noradtux/evnotipi-hat/evnotipi-hat.kicad_pcb

## KiCad design evnotipi-hat.kicad_pcb (2020-08-14)

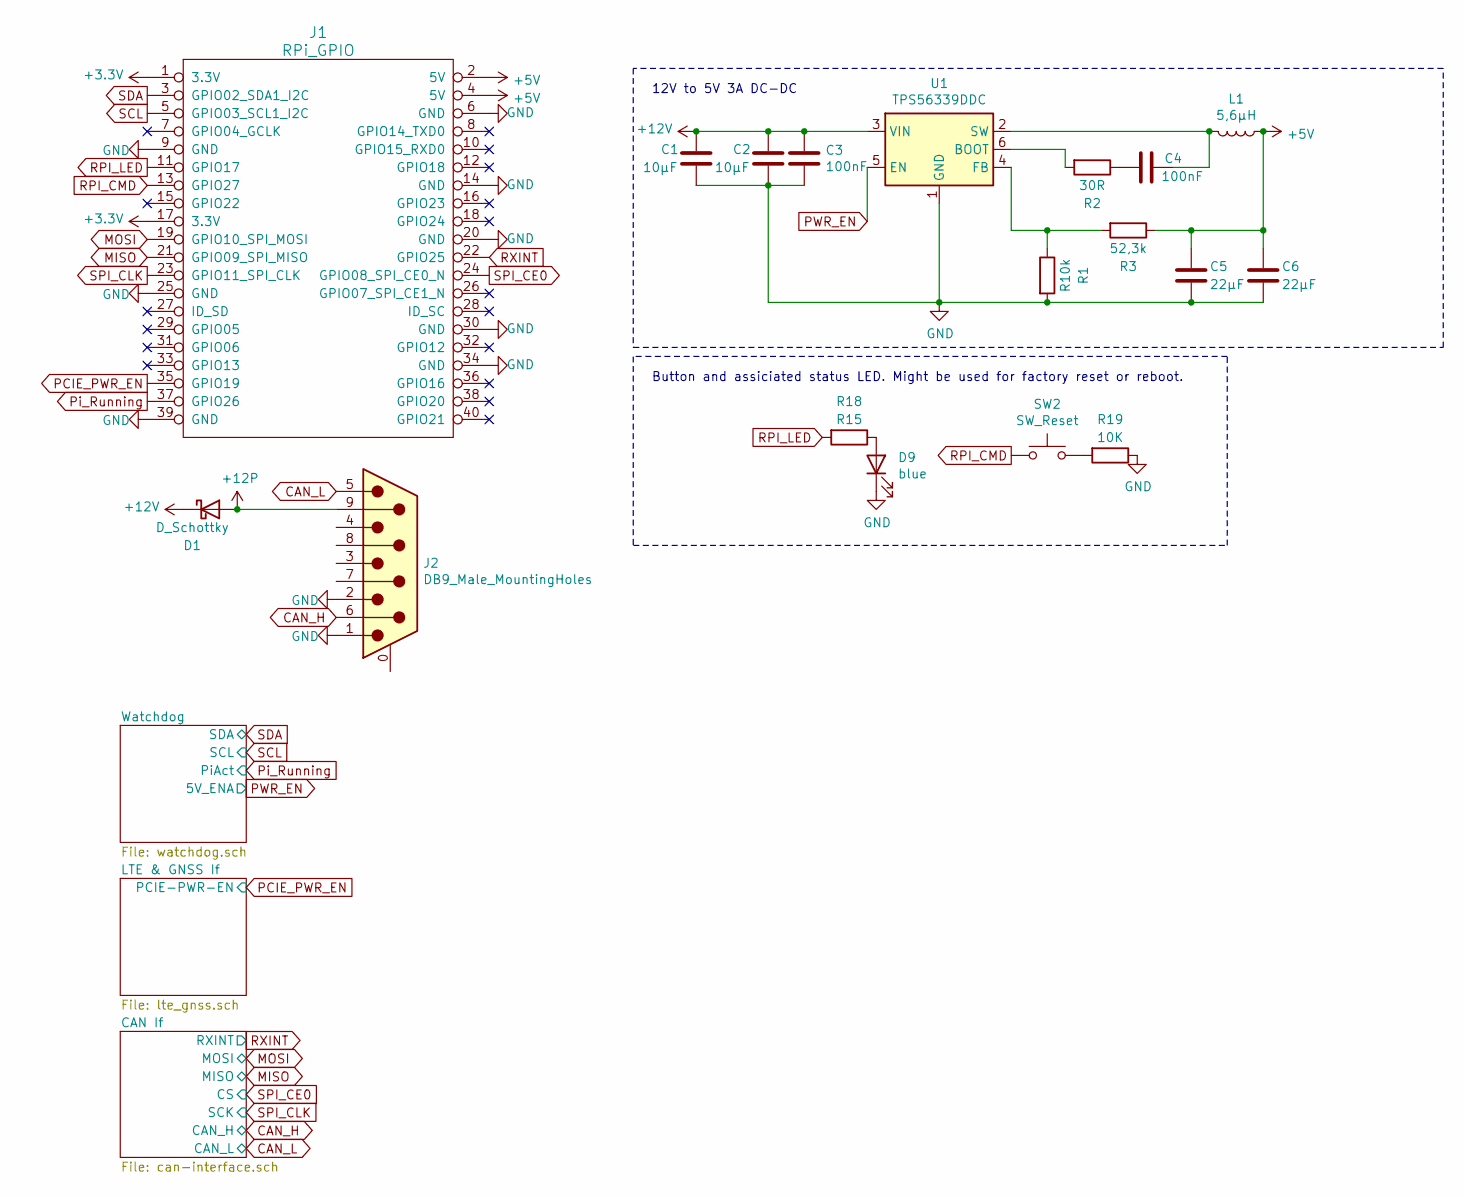
[picture p1: schematic evnotipi-hat.sch]

Parts:
C1, C2: 10µF; C_0805_2012Metric_Pad1.15x1.40mm_HandSolder
C3, C4: 100nF; C_0805_2012Metric_Pad1.15x1.40mm_HandSolder
C5, C6: 22µF; C_0805_2012Metric_Pad1.15x1.40mm_HandSolder
D1: D_Schottky; D_SOD-128
D9: blue; LED_0603_1608Metric
J1: RPi_GPIO; Samtec_HLE-120-02-xxx-DV-BE-A_2x20_RPi_Top
J2: DB9_Male_MountingHoles; DSUB-9_Male_Horizontal_P2.77x2.84mm_EdgePinOffset4.94mm_Hou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
L1: 5,6µH; L_Coilcraft_XAL60xx_6.36x6.56mm
R1: R10k; R_0603_1608Metric_Pad1.05x0.95mm_HandSolder
R2: 30R; R_0603_1608Metric_Pad1.05x0.95mm_HandSolder
R3: 52,3k; R_0603_1608Metric_Pad1.05x0.95mm_HandSolder
R18: R15; R_0603_1608Metric_Pad1.05x0.95mm_HandSolder
R19: 10K; R_0603_1608Metric_Pad1.05x0.95mm_HandSolder
SW2: SW_Reset; SW_SPST_B3U-1000P
U1: TPS56339DDC; SOT-23-6

Connections:
+5V: C5.1, C6.1, J1.2 (5V), J1.4 (5V), L1.1, R3.1; also elsewhere on the board
+12P: D1.2 (A), J2.9; also elsewhere on the board
+12V: C1.1, C2.1, C3.1, D1.1 (K), U1.3 (VIN); also elsewhere on the board
CAN_H: J2.6; also elsewhere on the board
CAN_L: J2.5; also elsewhere on the board
GND: C1.2, C2.2, C3.2, C5.2, C6.2, D9.1 (K), J1.6 (GND), J1.9 (GND), J1.14 (GND), J1.20 (GND), J1.25 (GND), J1.30 (GND), J1.34 (GND), J1.39 (GND), J2.1, J2.2, R1.2, R19.1, U1.1 (GND); also elsewhere on the board
MISO: J1.21 (GPIO09_SPI_MISO); also elsewhere on the board
MOSI: J1.19 (GPIO10_SPI_MOSI); also elsewhere on the board
unnamed: C4.1, L1.2, U1.2 (SW)
unnamed: C4.2, R2.1
unnamed: D9.2 (A), R18.1
unnamed: R1.1, R3.2, U1.4 (FB)
unnamed: R2.2, U1.6 (BOOT)
unnamed: R19.2, SW2.2
PCIE_PWR_EN: J1.35 (GPIO19); also elsewhere on the board
PWR_EN: U1.5 (EN); also elsewhere on the board
Pi_Running: J1.37 (GPIO26); also elsewhere on the board
RPI_CMD: J1.13 (GPIO27), SW2.1
RPI_LED: J1.11 (GPIO17), R18.2
RXINT: J1.22 (GPIO25); also elsewhere on the board
SCL: J1.5 (GPIO03_SCL1_I2C); also elsewhere on the board
SDA: J1.3 (GPIO02_SDA1_I2C); also elsewhere on the board
SPI_CE0: J1.24 (GPIO08_SPI_CE0_N); also elsewhere on the board
SPI_CLK: J1.23 (GPIO11_SPI_CLK); also elsewhere on the board

Notes on the sheet:
12V to 5V 3A DC-DC
Button and assiciated status LED. Might be used for factory reset or reboot.

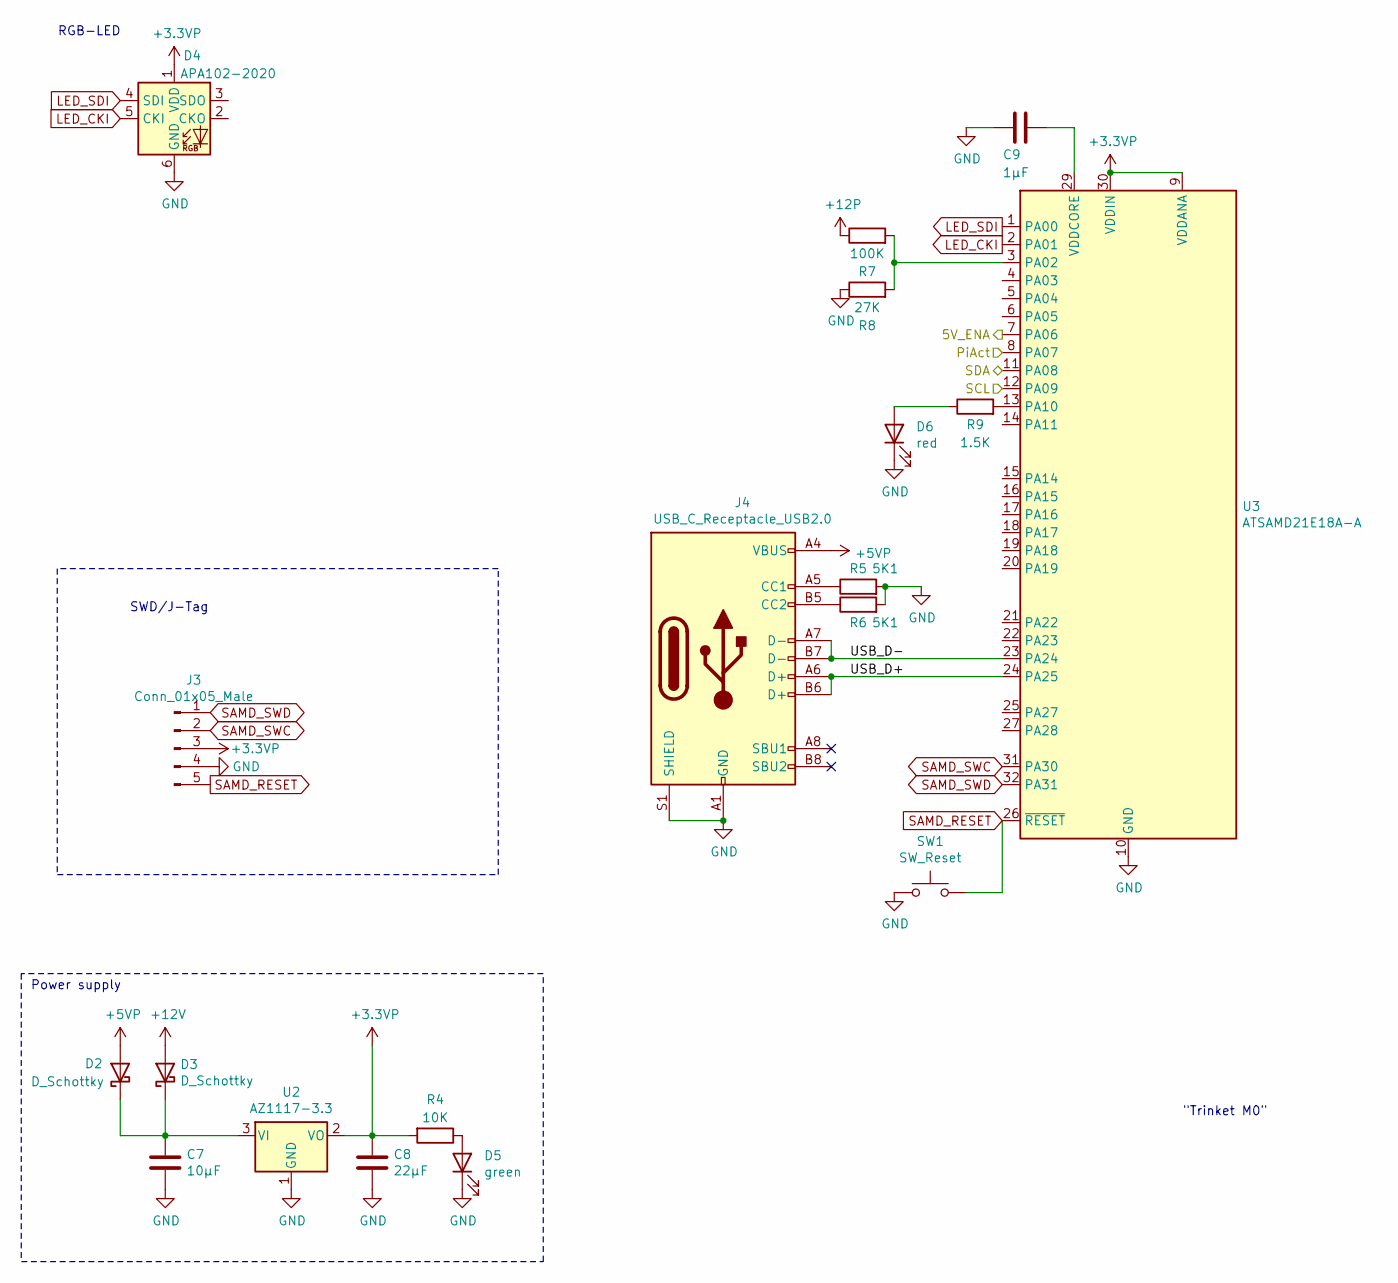
[picture p2: schematic watchdog.sch]

Parts:
C7: 10µF; C_0805_2012Metric_Pad1.15x1.40mm_HandSolder
C8: 22µF; C_0805_2012Metric_Pad1.15x1.40mm_HandSolder
C9: 1µF; C_0805_2012Metric_Pad1.15x1.40mm_HandSolder
D2, D3: D_Schottky; D_SOD-128
D4: APA102-2020; LED-APA102-2020
D5: green; LED_0603_1608Metric
D6: red; LED_0603_1608Metric
J3: Conn_01x05_Male; Molex_PicoBlade_53047-0510_1x05_P1.25mm_Vertical
J4: USB_C_Receptacle_USB2.0; USB_C_Receptacle_HRO_TYPE-C-31-M-12
R4: 10K; R_0603_1608Metric_Pad1.05x0.95mm_HandSolder
R5, R6: 5K1; R_0603_1608Metric_Pad1.05x0.95mm_HandSolder
R7: 100K; R_0603_1608Metric_Pad1.05x0.95mm_HandSolder
R8: 27K; R_0603_1608Metric_Pad1.05x0.95mm_HandSolder
R9: 1.5K; R_0603_1608Metric_Pad1.05x0.95mm_HandSolder
SW1: SW_Reset; SW_SPST_B3U-1000P
U2: AZ1117-3.3; SOT-223
U3: ATSAMD21E18A-A; TQFP-32_7x7mm_P0.8mm

Connections:
+3.3VP: C8.1, D4.1 (VDD), J3.3, R4.2, U2.2 (VO), U3.9 (VDDANA), U3.30 (VDDIN)
+5VP: D2.2 (A), J4.A4 (VBUS), J4.A9 (VBUS), J4.B4 (VBUS), J4.B9 (VBUS)
+12P: R7.1; also elsewhere on the board
+12V: D3.2 (A); also elsewhere on the board
/Watchdog/USB_D+: J4.A6 (D+), J4.B6 (D+), U3.24 (PA25)
/Watchdog/USB_D-: J4.A7 (D-), J4.B7 (D-), U3.23 (PA24)
GND: C7.2, C8.2, C9.1, D4.6 (GND), D5.1 (K), D6.1 (K), J3.4, J4.A1 (GND), J4.A12 (GND), J4.B1 (GND), J4.B12 (GND), J4.S1 (SHIELD), R5.2, R6.2, R8.1, SW1.1, U2.1 (GND), U3.10 (GND), U3.28 (GND); also elsewhere on the board
LED_CKI: D4.5 (CKI), U3.2 (PA01)
LED_SDI: D4.4 (SDI), U3.1 (PA00)
unnamed: C7.1, D2.1 (K), D3.1 (K), U2.3 (VI)
unnamed: C9.2, U3.29 (VDDCORE)
unnamed: D5.2 (A), R4.1
unnamed: D6.2 (A), R9.1
unnamed: J4.A5 (CC1), R5.1
unnamed: J4.B5 (CC2), R6.1
unnamed: R7.2, R8.2, U3.3 (PA02)
unnamed: R9.2, U3.13 (PA10)
PWR_EN: U3.7 (PA06); also elsewhere on the board
Pi_Running: U3.8 (PA07); also elsewhere on the board
SAMD_RESET: J3.5, SW1.2, U3.26 (~RESET)
SAMD_SWC: J3.2, U3.31 (PA30)
SAMD_SWD: J3.1, U3.32 (PA31)
SCL: U3.12 (PA09); also elsewhere on the board
SDA: U3.11 (PA08); also elsewhere on the board

Notes on the sheet:
"Trinket M0"
Power supply
SWD/J-Tag
RGB-LED

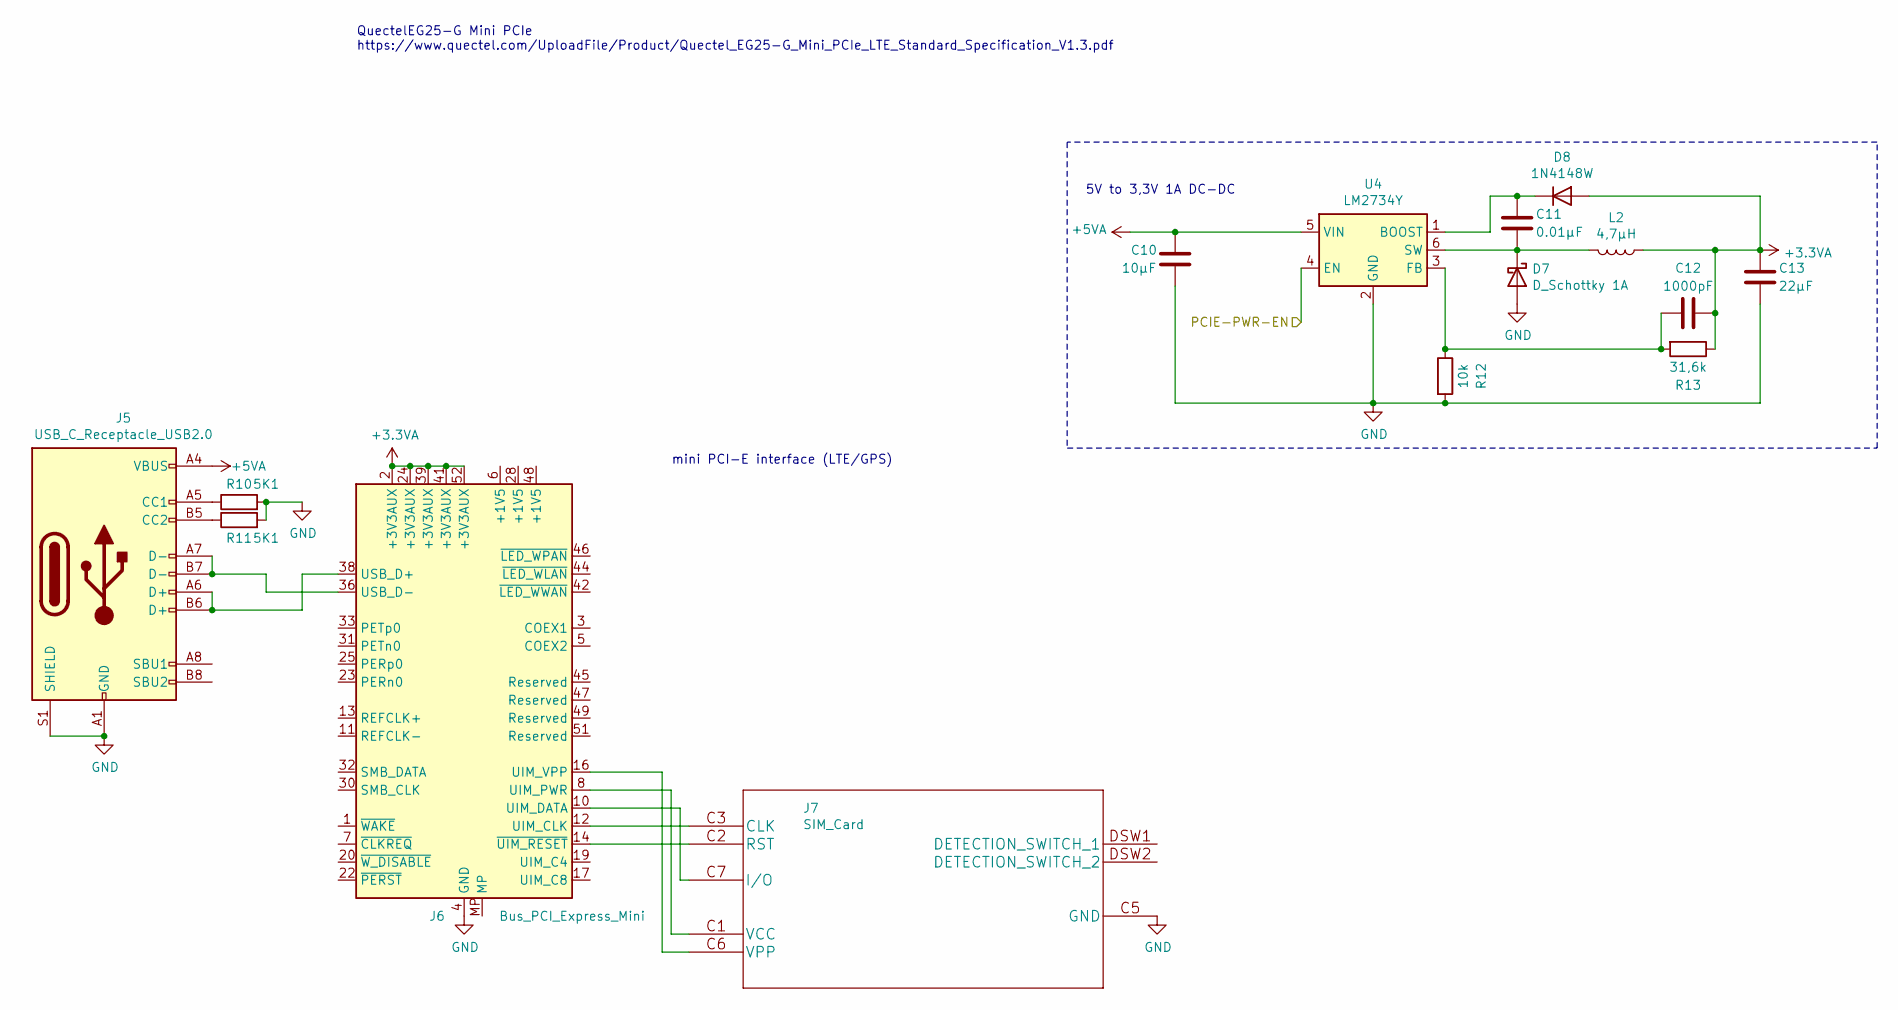
[picture p3: schematic lte_gnss.sch]

Parts:
C10: 10µF; C_0805_2012Metric_Pad1.15x1.40mm_HandSolder
C11: 0.01µF; C_0805_2012Metric_Pad1.15x1.40mm_HandSolder
C12: 1000pF; C_0805_2012Metric_Pad1.15x1.40mm_HandSolder
C13: 22µF; C_0805_2012Metric_Pad1.15x1.40mm_HandSolder
D7: D_Schottky 1A; D_SOD-128
D8: 1N4148W; D_SOD-128
J5: USB_C_Receptacle_USB2.0; USB_C_Receptacle_HRO_TYPE-C-31-M-12
J6: Bus_PCI_Express_Mini; BUS_PCI_Express_Mini_Full
J7: SIM_Card; SF56S006V4BR2000
L2: 4,7µH; L_Coilcraft_XAL60xx_6.36x6.56mm
R10, R11: 5K1; R_0603_1608Metric_Pad1.05x0.95mm_HandSolder
R12: 10k; R_0603_1608Metric_Pad1.05x0.95mm_HandSolder
R13: 31,6k; R_0603_1608Metric_Pad1.05x0.95mm_HandSolder
U4: LM2734Y; TSOT-23-6_HandSoldering

Connections:
+3.3VA: C12.1, C13.1, D8.2 (A), J6.2 (+3V3AUX), J6.24 (+3V3AUX), J6.39 (+3V3AUX), J6.41 (+3V3AUX), J6.52 (+3V3AUX), L2.1, R13.1
+5VA: C10.1, J5.A4 (VBUS), J5.A9 (VBUS), J5.B4 (VBUS), J5.B9 (VBUS), U4.5 (VIN)
GND: C10.2, C13.2, D7.2 (A), J5.A1 (GND), J5.A12 (GND), J5.B1 (GND), J5.B12 (GND), J5.S1 (SHIELD), J6.4 (GND), J6.9 (GND), J6.15 (GND), J6.18 (GND), J6.21 (GND), J6.26 (GND), J6.27 (GND), J6.29 (GND), J6.34 (GND), J6.35 (GND), J6.37 (GND), J6.40 (GND), J6.43 (GND), J6.50 (GND), J7.C5 (GND), R10.2, R11.2, R12.2, U4.2 (GND); also elsewhere on the board
unnamed: C11.1, D8.1 (K), U4.1 (BOOST)
unnamed: C11.2, D7.1 (K), L2.2, U4.6 (SW)
unnamed: C12.2, R12.1, R13.2, U4.3 (FB)
unnamed: J5.A5 (CC1), R10.1
unnamed: J5.A6 (D+), J5.B6 (D+), J6.38 (USB_D+)
unnamed: J5.A7 (D-), J5.B7 (D-), J6.36 (USB_D-)
unnamed: J5.B5 (CC2), R11.1
unnamed: J6.8 (UIM_PWR), J7.C1 (VCC)
unnamed: J6.10 (UIM_DATA), J7.C7 (I/O)
unnamed: J6.12 (UIM_CLK), J7.C3 (CLK)
unnamed: J6.14 (~UIM_RESET), J7.C2 (RST)
unnamed: J6.16 (UIM_VPP), J7.C6 (VPP)
PCIE_PWR_EN: U4.4 (EN); also elsewhere on the board

Notes on the sheet:
QuectelEG25-G Mini PCIe https://www.quectel.com/UploadFile/Product/Quectel_EG25-G_Mini_PCIe_LTE_Standard_Specification_V1.3.pdf
mini PCI-E interface (LTE/GPS)
5V to 3,3V 1A DC-DC

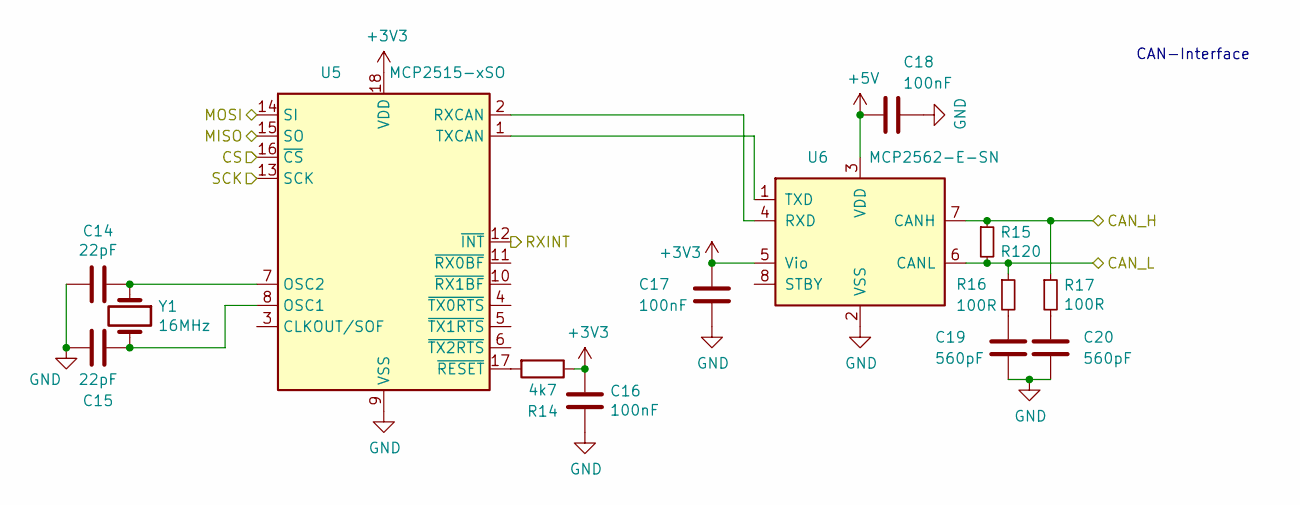
[picture p4: schematic can-interface.sch]

Parts:
C14, C15: 22pF; C_0805_2012Metric_Pad1.15x1.40mm_HandSolder
C16, C17, C18: 100nF; C_0805_2012Metric_Pad1.15x1.40mm_HandSolder
C19, C20: 560pF; C_0805_2012Metric_Pad1.15x1.40mm_HandSolder
R14: 4k7; R_0603_1608Metric_Pad1.05x0.95mm_HandSolder
R15: R120; R_0603_1608Metric_Pad1.05x0.95mm_HandSolder
R16, R17: 100R; R_0603_1608Metric_Pad1.05x0.95mm_HandSolder
U5: MCP2515-xSO; SOIC-18W_7.5x11.6mm_P1.27mm
U6: MCP2562-E-SN; SOIC-8_3.9x4.9mm_P1.27mm
Y1: 16MHz; Crystal_SMD_Abracon_ABM3-2Pin_5.0x3.2mm

Connections:
+5V: C18.1, U6.3 (VDD); also elsewhere on the board
CAN_H: R15.1, R17.1, U6.7 (CANH); also elsewhere on the board
CAN_L: R15.2, R16.1, U6.6 (CANL); also elsewhere on the board
GND: C14.2, C15.2, C16.1, C17.1, C18.2, C19.1, C20.1, U5.9 (VSS), U6.2 (VSS); also elsewhere on the board
MISO: U5.15 (SO); also elsewhere on the board
MOSI: U5.14 (SI); also elsewhere on the board
unnamed: C14.1, U5.7 (OSC2), Y1.1
unnamed: C15.1, U5.8 (OSC1), Y1.2
unnamed: C19.2, R16.2
unnamed: C20.2, R17.2
unnamed: R14.2, U5.17 (~RESET)
unnamed: U5.1 (TXCAN), U6.1 (TXD)
unnamed: U5.2 (RXCAN), U6.4 (RXD)
RXINT: U5.12 (~INT); also elsewhere on the board
SPI_CE0: U5.16 (~CS); also elsewhere on the board
SPI_CLK: U5.13 (SCK); also elsewhere on the board

Notes on the sheet:
CAN-Interface

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
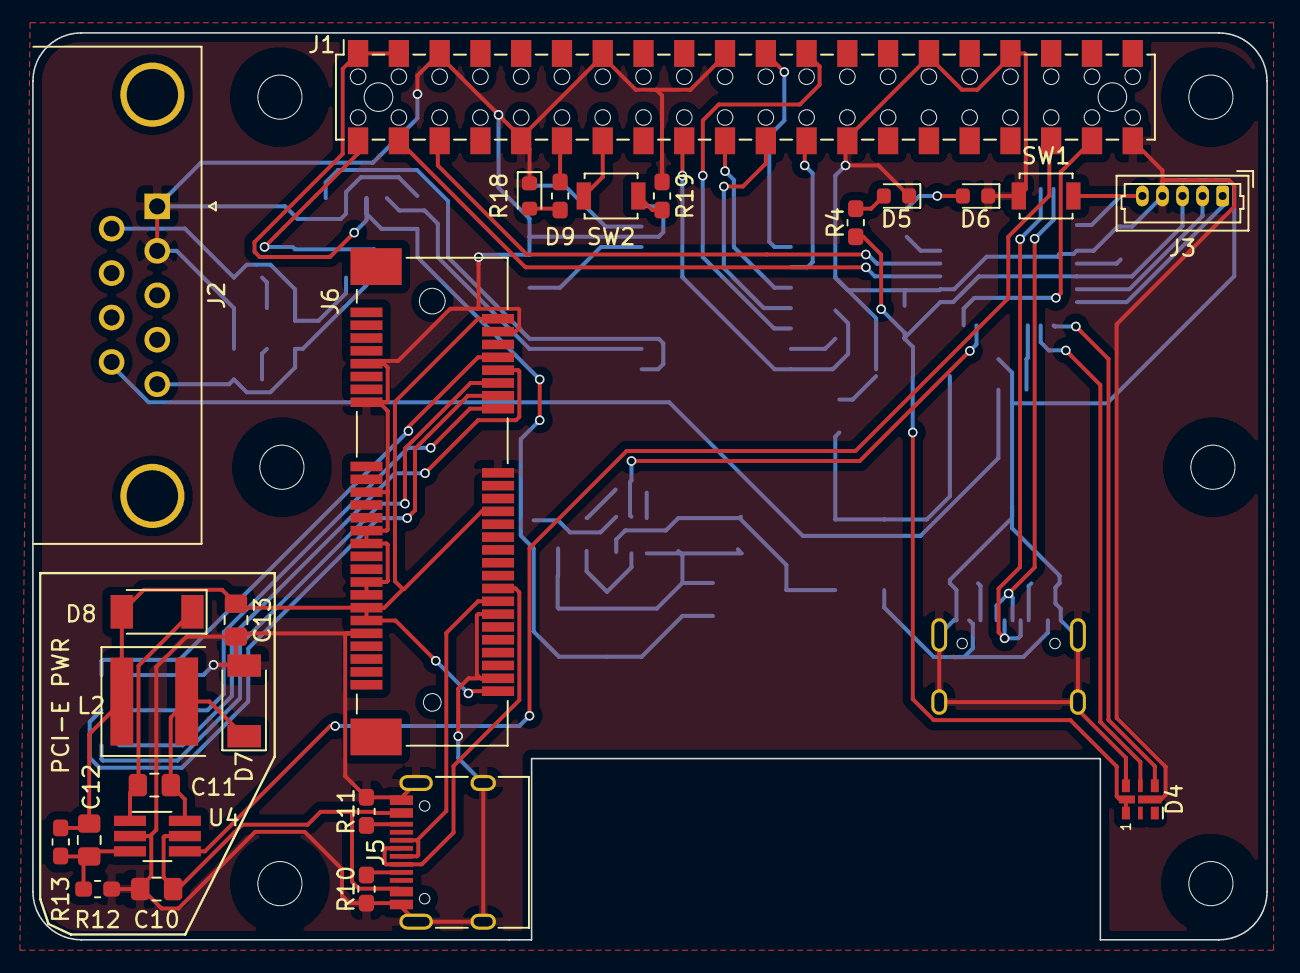
[picture p5: board evnotipi-hat.kicad_pcb from above]

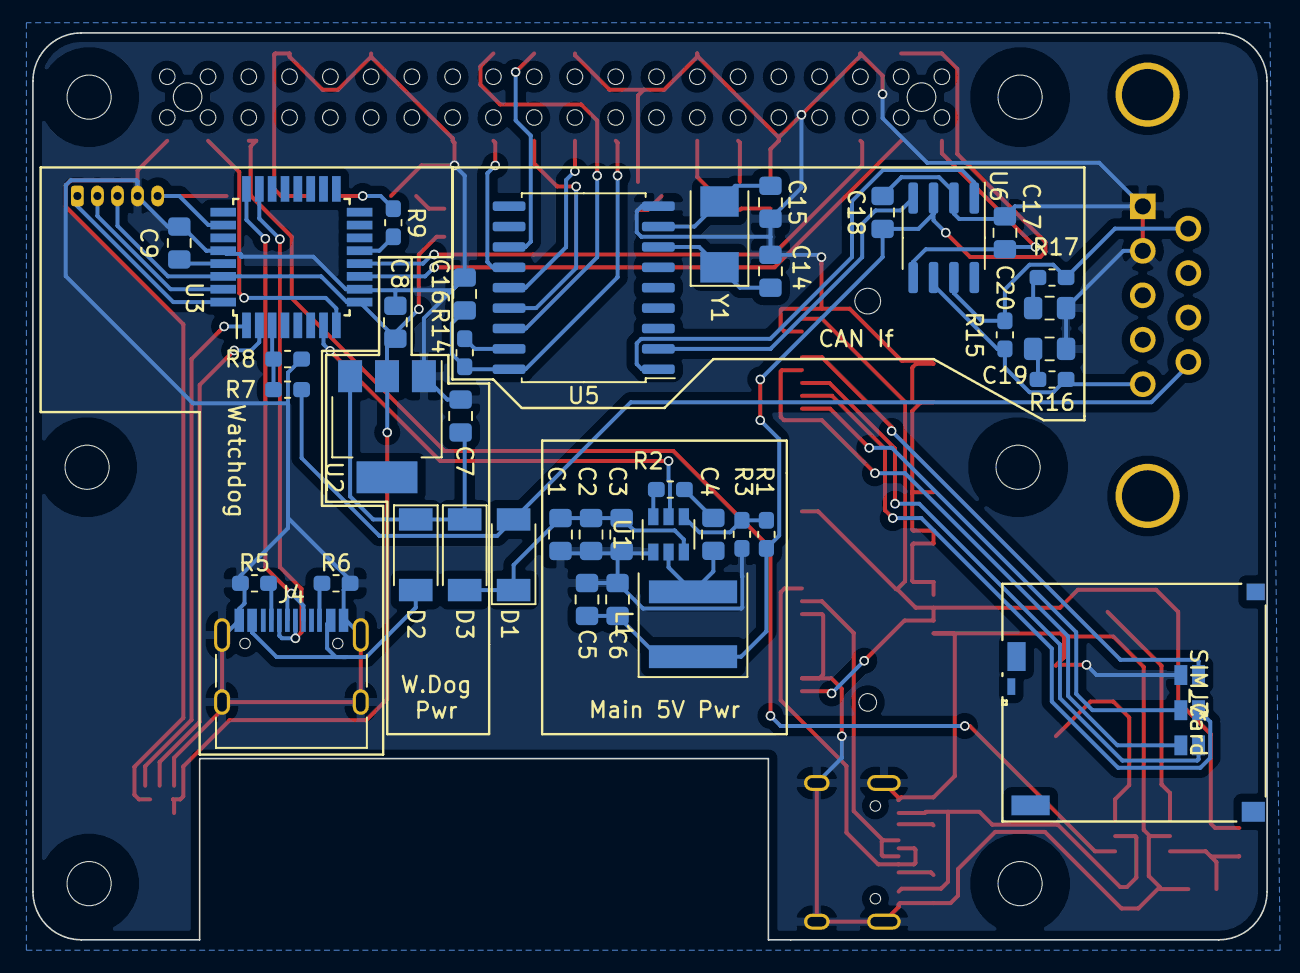
[picture p6: board evnotipi-hat.kicad_pcb from below]

Board: 2 copper layers, 76.9 x 56.5 mm, 66 parts (40 on the bottom side), 63 nets.
